npgo22/chickensticks/chickensticks.kicad_pcb

## KiCad design chickensticks.kicad_pcb (2026-04-28)

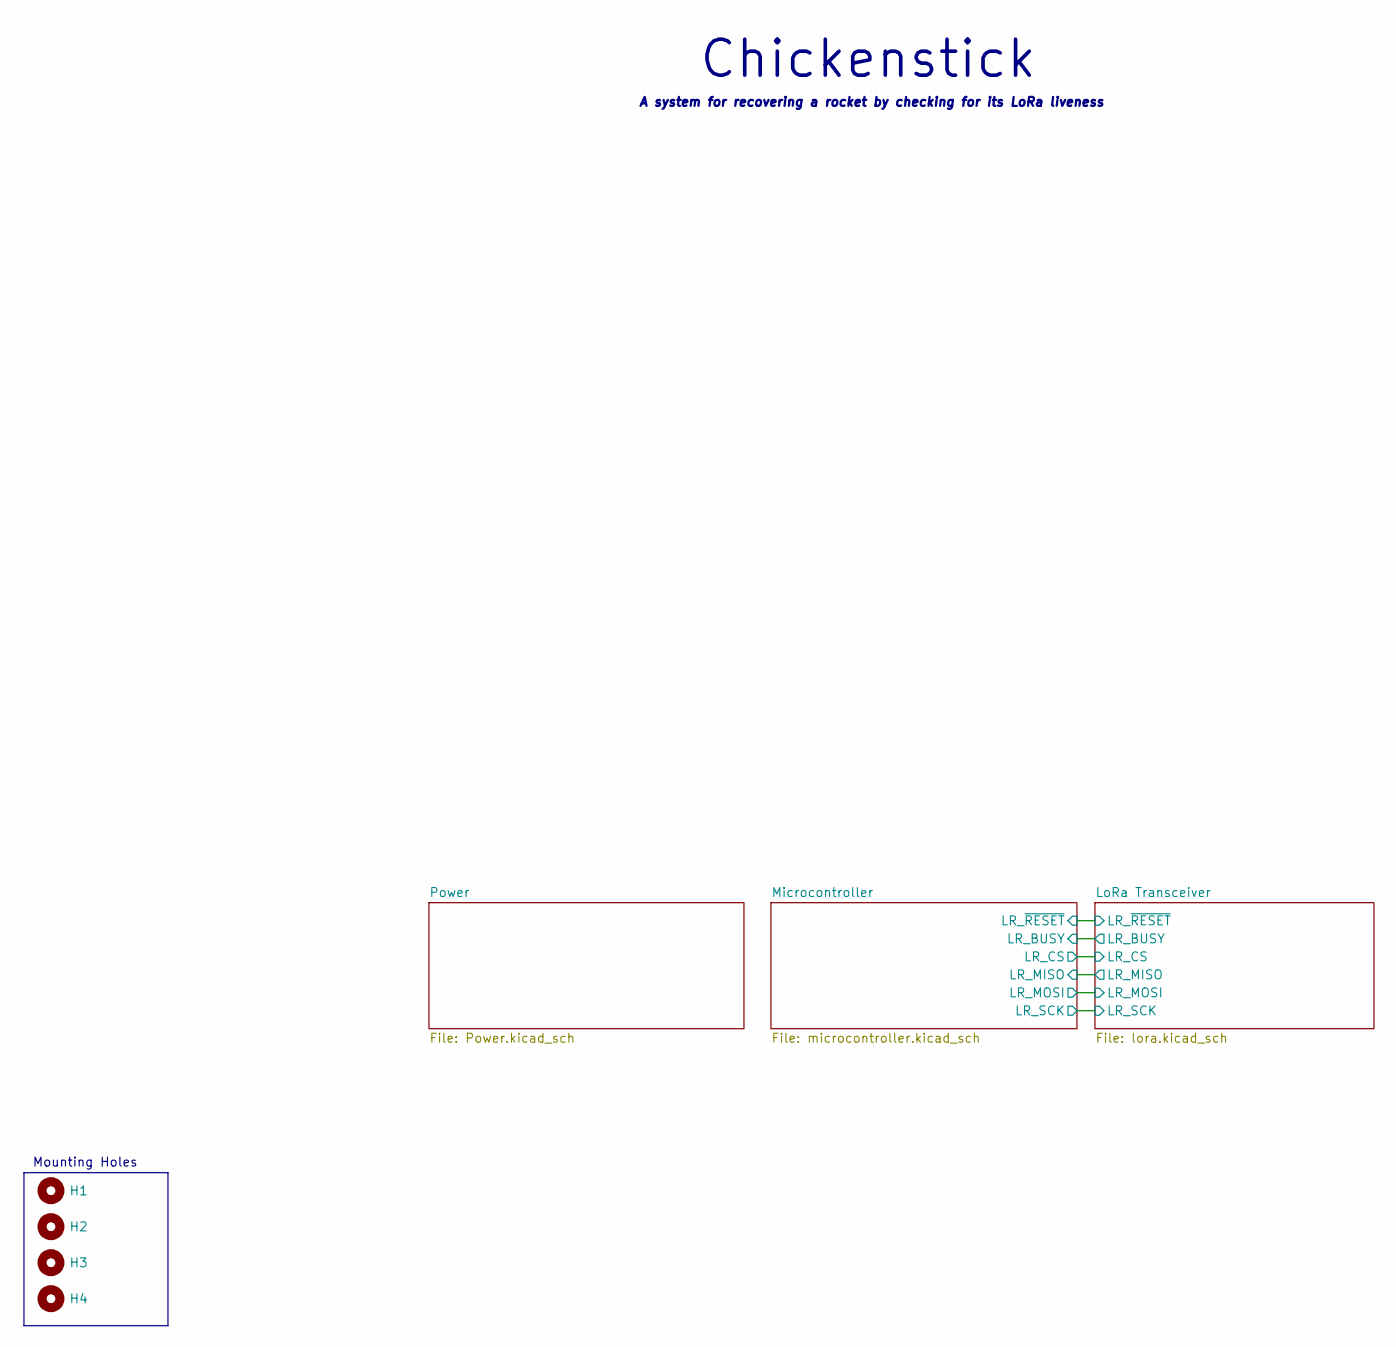
[picture p2: schematic chickensticks.kicad_sch, Chickenstick]

Parts:
H1, H2, H3, H4: MountingHole; MountingHole_3.2mm_M3

Notes on the sheet:
Chickenstick
A system for recovering a rocket by checking for its LoRa liveness
Mounting Holes

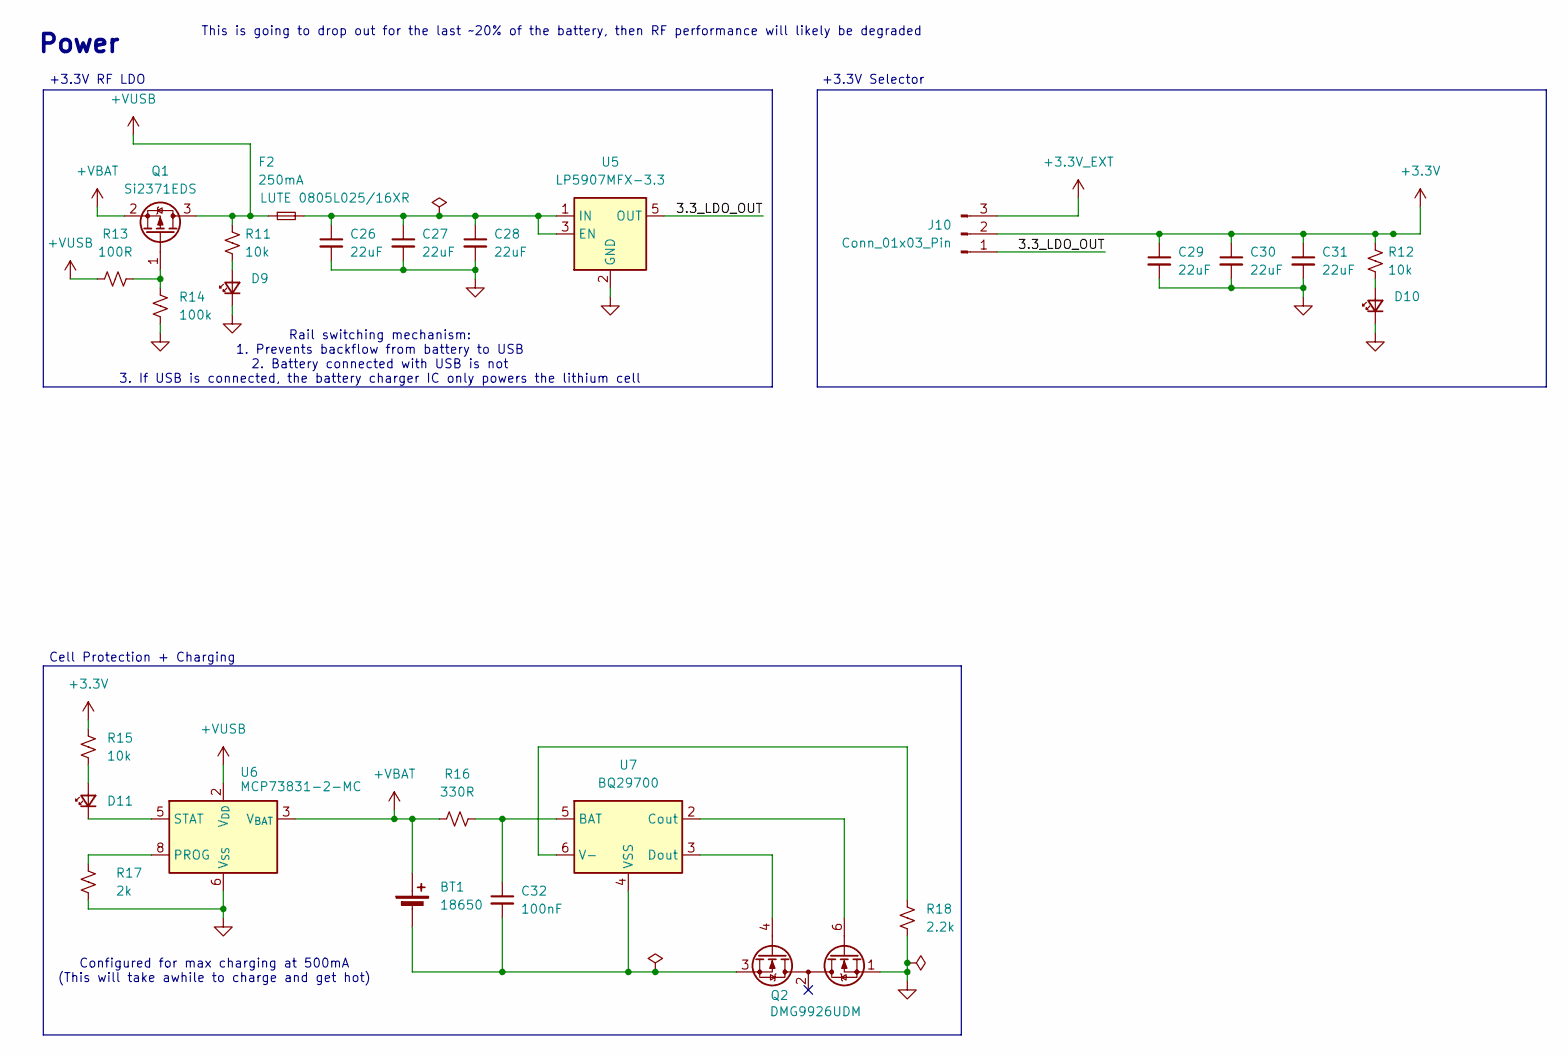
[picture p3: schematic Power.kicad_sch, Chickenstick]

Parts:
BT1: 18650; BatteryHolder_Keystone_1042_1x18650
C26, C27, C28, C29, C30, C31: 22uF; C_0805
C32: 100nF; C_0603
D9, D10, D11: LED_Small; LED_0603
F2: 250mA; Fuse_0805_2012Metric
J10: Conn_01x03_Pin; PinHeader_1x03_P2.54mm_Vertical
Q1: Si2371EDS; SOT-23
Q2: DMG9926UDM; SOT-23-6
R11, R12, R15: 10k; R_0603
R13: 100R; R_0603
R14: 100k; R_0603
R16: 330R; R_0603
R17: 2k; R_0603
R18: 2.2k; R_0603
U5: LP5907MFX-3.3; SOT-23-5
U6: MCP73831-2-MC; DFN-8-1EP_3x2mm_P0.5mm_EP1.7x1.4mm
U7: BQ29700; WSON-6_1.5x1.5mm_P0.5mm

Connections:
+3.3V: C29.1, C30.1, C31.1, J10.2, R12.1, R15.2; also elsewhere on the board
+3.3V_EXT: J10.3; also elsewhere on the board
+VUSB: F2.1, Q1.3 (D), R11.1, R13.1, U6.1 (V_{DD}), U6.2 (V_{DD}); also elsewhere on the board
/Power/3.3_LDO_OUT: J10.1, U5.5 (OUT)
unnamed: BT1.2 (-), C32.2, Q2.3 (S2), U7.4 (VSS)
unnamed: D9.2 (A), R11.2
unnamed: D10.2 (A), R12.2
unnamed: D11.2 (A), R15.1
unnamed: D11.1 (K), U6.5 (STAT)
unnamed: Q1.1 (G), R13.2, R14.1
unnamed: Q2.6 (G1), U7.2 (Cout)
unnamed: Q2.4 (G2), U7.3 (Dout)
unnamed: C26.1, C27.1, C28.1, F2.2, U5.1 (IN), U5.3 (EN)
unnamed: R17.1, U6.8 (PROG)
unnamed: C32.1, R16.2, U7.5 (BAT)
unnamed: R18.1, U7.6 (V-)

Notes on the sheet:
Configured for max charging at 500mA (This will take awhile to charge and get hot)
This is going to drop out for the last ~20% of the battery, then RF performance will likely be degraded
Power
Rail switching mechanism: 1. Prevents backflow from battery to USB 2. Battery connected with USB is not 3. If USB is connected, the battery charger IC only powers the lithium cell
+3.3V RF LDO
Cell Protection + Charging
+3.3V Selector

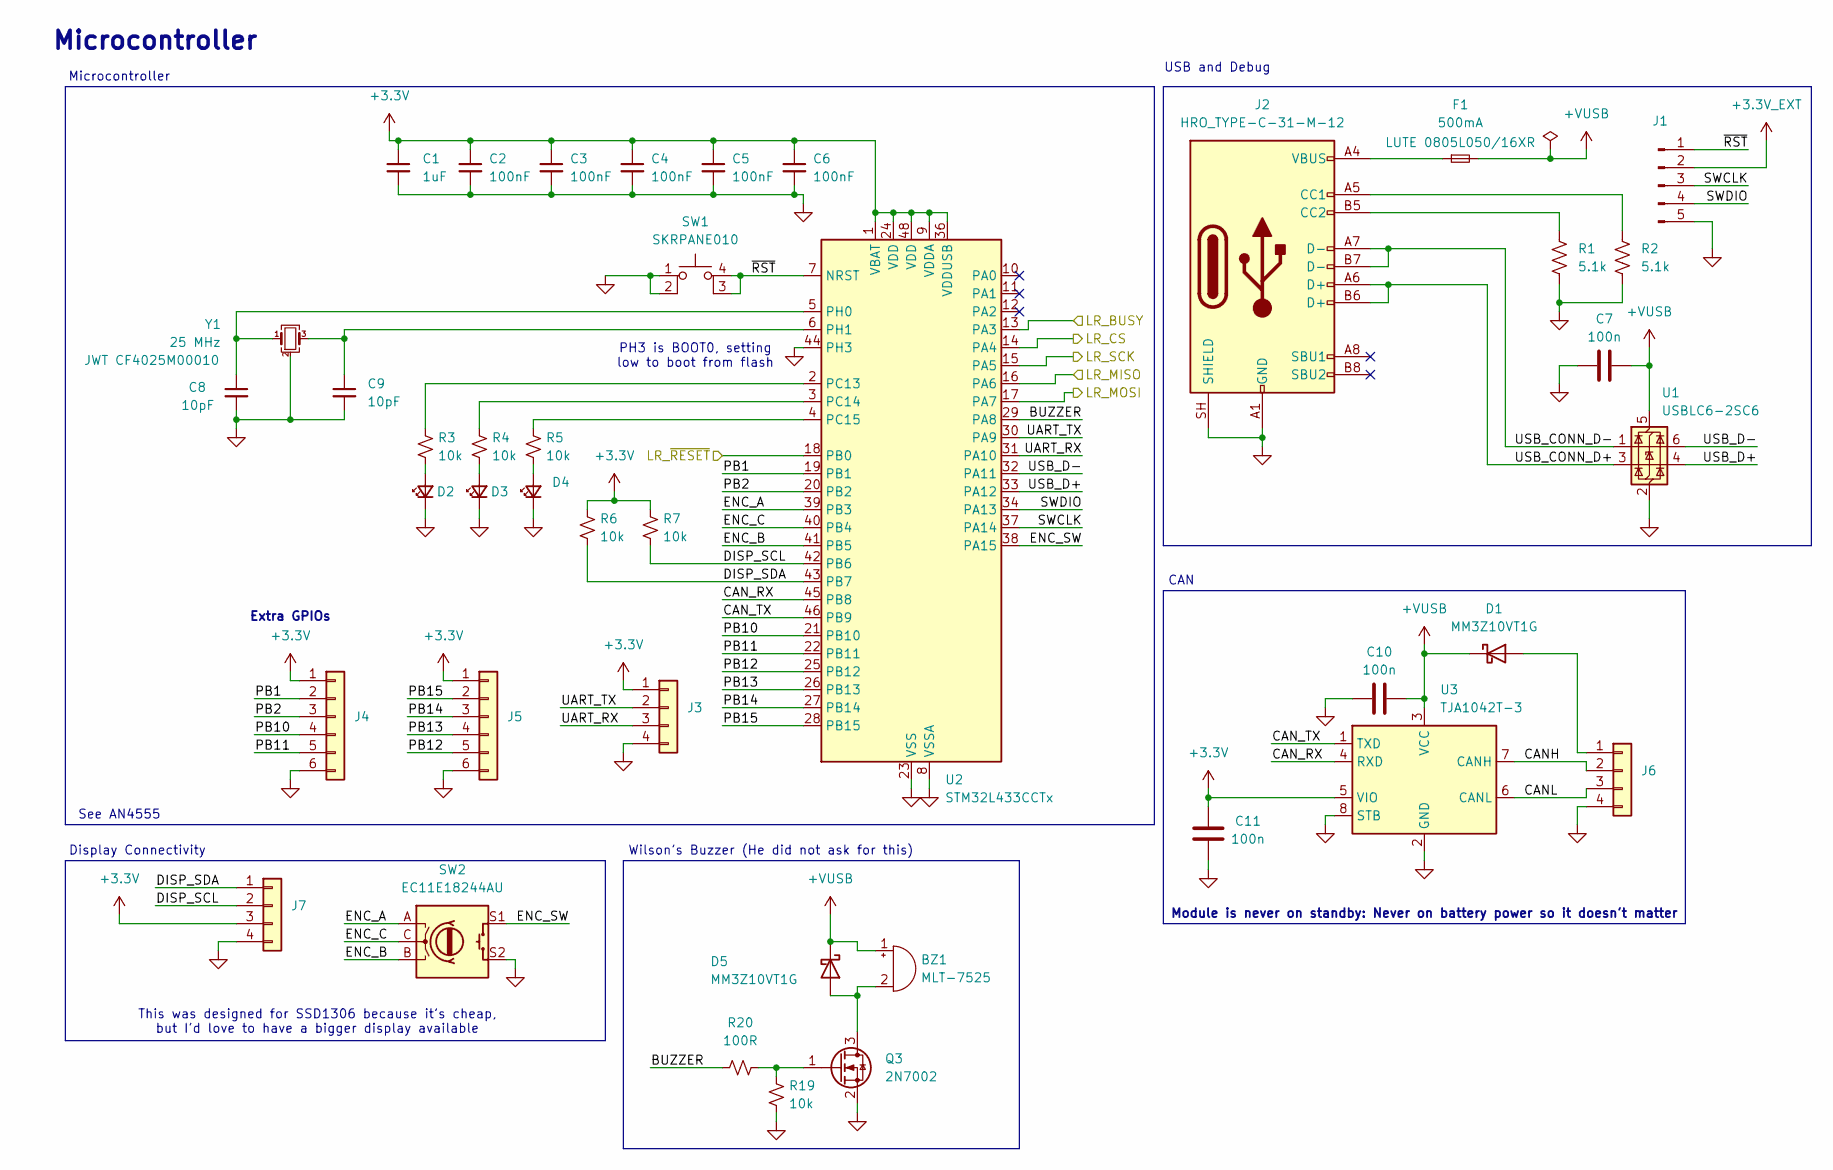
[picture p4: schematic microcontroller.kicad_sch, Chickenstick]

Parts:
BZ1: MLT-7525
C1: 1uF; C_0805
C2, C3, C4, C5, C6: 100nF; C_0603
C7, C10, C11: 100n; C_0603
C8, C9: 10pF; C_0603
D1, D5: MM3Z10VT1G; SOD-323
D2, D3, D4: LED_Small; LED_0603
F1: 500mA; Fuse_0805_2012Metric
J1: Conn_01x05_Pin; PinHeader_1x05_P2.54mm_Vertical
J2: HRO_TYPE-C-31-M-12; USB_C_Receptacle_HRO_TYPE-C-31-M-12
J3, J6, J7: Conn_01x04; PinHeader_1x04_P2.54mm_Vertical
J4, J5: Conn_01x06; PinHeader_1x06_P2.54mm_Vertical
Q3: 2N7002; SOT-23
R1, R2: 5.1k; R_0603
R3, R4, R5, R6, R7, R19: 10k; R_0603
R20: 100R; R_0603
SW1: SKRPANE010
SW2: EC11E18244AU; RotaryEncoder_Alps_EC11E-Switch_Vertical_H20mm_MountingHoles
U1: USBLC6-2SC6; SOT-23-6
U2: STM32L433CCTx; LQFP-48_7x7mm_P0.5mm
U3: TJA1042T-3; SOIC-8_3.9x4.9mm_P1.27mm
Y1: 25 MHz; 3225-4P-L

Connections:
+3.3V: C1.1, C2.1, C3.1, C4.1, C5.1, C6.1, C11.2, J3.1, J4.1, J5.1, J7.3, R6.1, R7.1, U2.1 (VBAT), U2.9 (VDDA), U2.24 (VDD), U2.36 (VDDUSB), U2.48 (VDD), U3.5 (VIO); also elsewhere on the board
+3.3V_EXT: J1.2; also elsewhere on the board
+VUSB: BZ1.1 (+), C7.2, C10.2, D1.1 (K), D5.1 (K), F1.2, U1.5 (VBUS), U3.3 (VCC); also elsewhere on the board
/LoRa Transceiver/LR_BUSY: U2.13 (PA3); also elsewhere on the board
/LoRa Transceiver/LR_CS: U2.14 (PA4); also elsewhere on the board
/LoRa Transceiver/LR_MISO: U2.16 (PA6); also elsewhere on the board
/LoRa Transceiver/LR_MOSI: U2.17 (PA7); also elsewhere on the board
/LoRa Transceiver/LR_SCK: U2.15 (PA5); also elsewhere on the board
/LoRa Transceiver/LR_~RESET: U2.18 (PB0); also elsewhere on the board
/Microcontroller/BUZZER: R20.1, U2.29 (PA8)
/Microcontroller/CANH: J6.2, U3.7 (CANH)
/Microcontroller/CANL: J6.3, U3.6 (CANL)
/Microcontroller/CAN_RX: U2.45 (PB8), U3.4 (RXD)
/Microcontroller/CAN_TX: U2.46 (PB9), U3.1 (TXD)
/Microcontroller/DISP_SCL: J7.2, R7.2, U2.42 (PB6)
/Microcontroller/DISP_SDA: J7.1, R6.2, U2.43 (PB7)
/Microcontroller/ENC_A: SW2.A, U2.39 (PB3)
/Microcontroller/ENC_B: SW2.B, U2.41 (PB5)
/Microcontroller/ENC_C: SW2.C, U2.40 (PB4)
/Microcontroller/ENC_SW: SW2.S1, U2.38 (PA15)
/Microcontroller/PB1: J4.2, U2.19 (PB1)
/Microcontroller/PB2: J4.3, U2.20 (PB2)
/Microcontroller/PB10: J4.4, U2.21 (PB10)
/Microcontroller/PB11: J4.5, U2.22 (PB11)
/Microcontroller/PB12: J5.5, U2.25 (PB12)
/Microcontroller/PB13: J5.4, U2.26 (PB13)
/Microcontroller/PB14: J5.3, U2.27 (PB14)
/Microcontroller/PB15: J5.2, U2.28 (PB15)
/Microcontroller/SWCLK: J1.3, U2.37 (PA14)
/Microcontroller/SWDIO: J1.4, U2.34 (PA13)
/Microcontroller/UART_RX: J3.3, U2.31 (PA10)
/Microcontroller/UART_TX: J3.2, U2.30 (PA9)
/Microcontroller/USB_CONN_D+: J2.A6 (D+), J2.B6 (D+), U1.3 (I/O2)
/Microcontroller/USB_CONN_D-: J2.A7 (D-), J2.B7 (D-), U1.1 (I/O1)
/Microcontroller/USB_D+: U1.4 (I/O2), U2.33 (PA12)
/Microcontroller/USB_D-: U1.6 (I/O1), U2.32 (PA11)
/Microcontroller/~RST: J1.1, SW1.3 (K), SW1.4 (A), U2.7 (NRST)
unnamed: BZ1.2 (-), D5.2 (A), Q3.3 (D)
unnamed: D1.2 (A), J6.1
unnamed: D2.2 (A), R3.2
unnamed: D3.2 (A), R4.2
unnamed: D4.2 (A), R5.2
unnamed: F1.1, J2.A4 (VBUS), J2.A9 (VBUS), J2.B4 (VBUS), J2.B9 (VBUS)
unnamed: J2.A5 (CC1), R2.1
unnamed: J2.B5 (CC2), R1.1
unnamed: Q3.1 (G), R19.1, R20.2
unnamed: R3.1, U2.2 (PC13)
unnamed: R4.1, U2.3 (PC14)
unnamed: R5.1, U2.4 (PC15)
unnamed: C8.1, U2.5 (PH0), Y1.1
unnamed: C9.1, U2.6 (PH1), Y1.3

Notes on the sheet:
Microcontroller
Extra GPIOs
Module is never on standby: Never on battery power so it doesn't matter
See AN4555
Display Connectivity
Wilson's Buzzer (He did not ask for this)
This was designed for SSD1306 because it's cheap, but I'd love to have a bigger display available
CAN
PH3 is BOOT0, setting low to boot from flash
USB and Debug

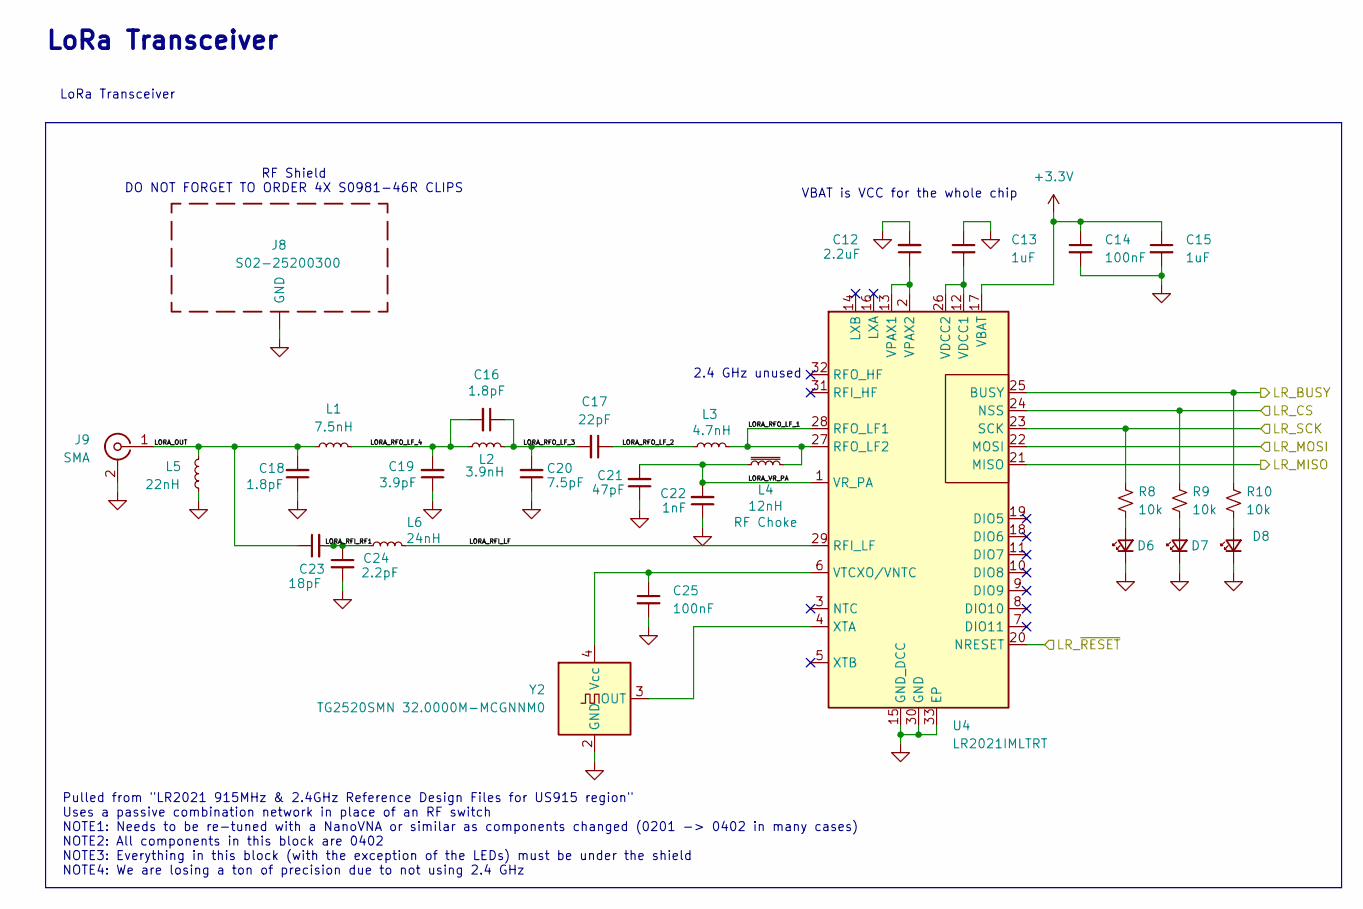
[picture p5: schematic lora.kicad_sch, Chickenstick]

Parts:
C12: 2.2uF; C_0805
C13, C15: 1uF; C_0805
C14, C25: 100nF; C_0603
C16, C18: 1.8pF; C_0402
C17: 22pF; C_0402
C19: 3.9pF; C_0402
C20: 7.5pF; C_0402
C21: 47pF; C_0402
C22: 1nF; C_0402
C23: 18pF; C_0402
C24: 2.2pF; C_0402
D6, D7, D8: LED_Small; LED_0603
J8: S02-25200300; S02-25200300-Outline
J9: SMA; SMA_Amphenol_132203-12_Horizontal
L1: 7.5nH; L_0402
L2: 3.9nH; L_0402
L3: 4.7nH; L_0402
L4: 12nH; L_0402
L5: 22nH; L_0402
L6: 24nH; L_0402
R8, R9, R10: 10k; R_0603
U4: LR2021IMLTRT; QFN-32_EP_5.8x5.8_Pitch0.5mm
Y2: TG2520SMN 32.0000M-MCGNNM0; Oscillator_SMD_SeikoEpson_TG2520SMN-xxx-xxxxxx-4Pin_2.5x2.0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

Connections:
+3.3V: C14.1, C15.1, U4.17 (VBAT); also elsewhere on the board
/LoRa Transceiver/LORA_OUT: C18.2, C23.1, J9.1 (In), L1.1, L5.2
/LoRa Transceiver/LORA_RFI_LF: L6.2, U4.29 (RFI_LF)
/LoRa Transceiver/LORA_RFI_RF1: C23.2, C24.1, L6.1
/LoRa Transceiver/LORA_RFO_LF_1: L3.2, L4.2, U4.27 (RFO_LF2), U4.28 (RFO_LF1)
/LoRa Transceiver/LORA_RFO_LF_2: C17.1, L3.1
/LoRa Transceiver/LORA_RFO_LF_3: C16.1, C17.2, C20.2, L2.2
/LoRa Transceiver/LORA_RFO_LF_4: C16.2, C19.2, L1.2, L2.1
/LoRa Transceiver/LORA_VR_PA: C21.2, C22.2, L4.1, U4.1 (VR_PA)
/LoRa Transceiver/LR_BUSY: R10.1, U4.25 (BUSY); also elsewhere on the board
/LoRa Transceiver/LR_CS: R9.1, U4.24 (NSS); also elsewhere on the board
/LoRa Transceiver/LR_MISO: U4.21 (MISO); also elsewhere on the board
/LoRa Transceiver/LR_MOSI: U4.22 (MOSI); also elsewhere on the board
/LoRa Transceiver/LR_SCK: R8.1, U4.23 (SCK); also elsewhere on the board
/LoRa Transceiver/LR_~RESET: U4.20 (NRESET); also elsewhere on the board
unnamed: D6.2 (A), R8.2
unnamed: D7.2 (A), R9.2
unnamed: D8.2 (A), R10.2
unnamed: C13.2, U4.12 (VDCC1), U4.26 (VDCC2)
unnamed: C12.1, U4.2 (VPAX2), U4.13 (VPAX1)
unnamed: C25.1, U4.6 (VTCXO/VNTC), Y2.4 (Vcc)
unnamed: U4.4 (XTA), Y2.3 (OUT)

Notes on the sheet:
RF Shield DO NOT FORGET TO ORDER 4X S0981-46R CLIPS
2.4 GHz unused
Pulled from "LR2021 915MHz & 2.4GHz Reference Design Files for US915 region" Uses a passive combination network in place of an RF switch NOTE1: Needs to be re-tuned with a NanoVNA or similar as components changed (0201 -> 0402 in many cases) NOTE2: All components in this block are 0402 NOTE3: Every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
VBAT is VCC for the whole chip
LoRa Transceiver

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
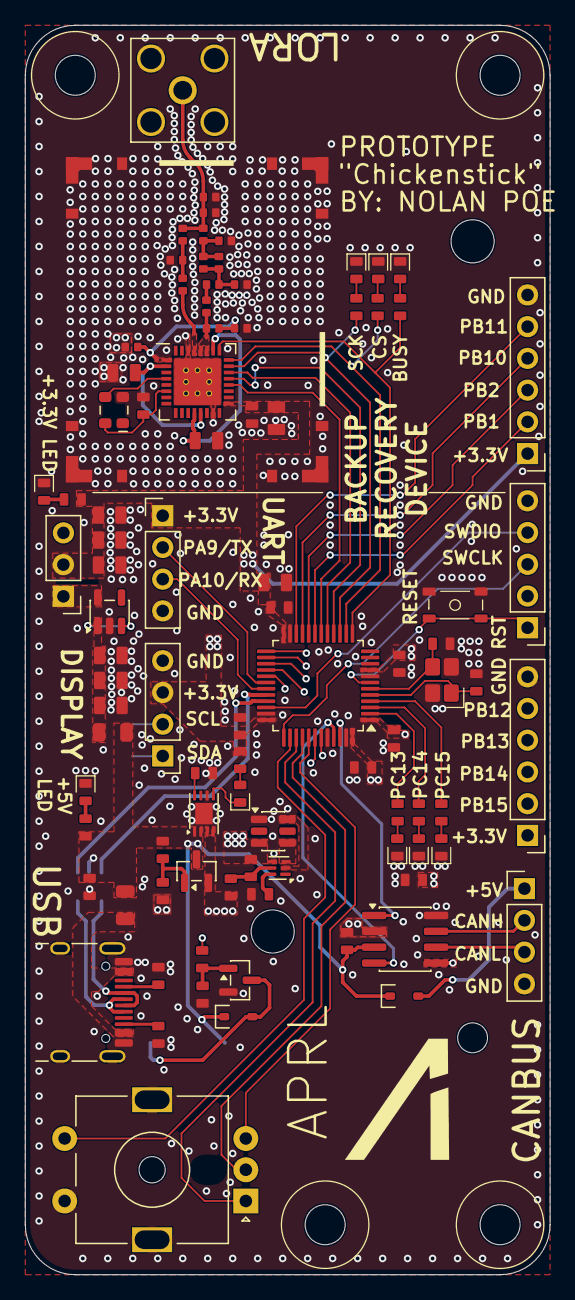
[picture p6: board chickensticks.kicad_pcb from above]

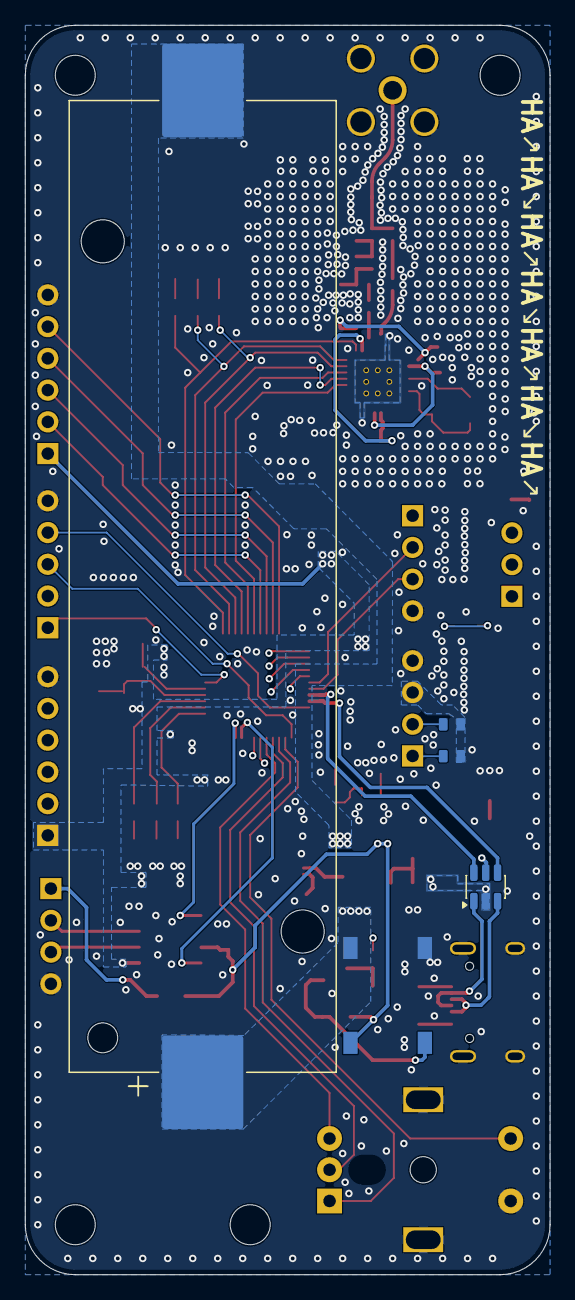
[picture p7: board chickensticks.kicad_pcb from below]

Board: 4 copper layers, 42.0 x 100.0 mm, 101 parts (5 on the bottom side), 81 nets.
