npgo22/chickensticks/chickensticks.ioc

Mcu.UserName=STM32L433CCTx
PA10.Signal=USART1_RX
PA11.Signal=USB_DM
PA12.Signal=USB_DP
PA3.GPIO_Label=LR_BUSY
PA3.Signal=GPIO_Input
PA4.GPIO_Label=LR_CS
PA4.Signal=GPIO_Output
PA5.Signal=SPI1_SCK
PA6.Signal=SPI1_MISO
PA7.Signal=SPI1_MOSI
PA8.Signal=GPIO_Output
PA9.Signal=USART1_TX
PB0.GPIO_Label=LR_RESET
PB0.Signal=GPIO_Output
PB5.Signal=GPIO_Input
PB6.Signal=I2C1_SCL
PB7.Signal=I2C1_SDA
PB8.Signal=CAN1_RX
PB9.Signal=CAN1_TX
PC13.GPIO_Label=LED1
PC13.Signal=GPIO_Output
PH3-BOOT0.GPIO_Label=BOOT0
PH3-BOOT0.Signal=EVENTOUT
