npgo22/chickensticks/(commit log)

2026-04-24 Initial review version
    [Power.kicad_sch, chickensticks.kicad_pcb, chickensticks.kicad_sch, lora.kicad_sch, microcontroller.kicad_sch]
2026-04-24 Implement first stage of review fixes
    [chickensticks.kicad_pcb]
2026-04-24 Add buzzer, fix some erc
    [Power.kicad_sch, chickensticks.kicad_pcb, lora.kicad_sch, microcontroller.kicad_sch]
2026-04-24 Run cleanup tracks and vias
    [chickensticks.kicad_pcb]
2026-04-28 Remove big SS14 diodes
    [chickensticks.kicad_pcb, chickensticks.kicad_sch, microcontroller.kicad_sch]
2026-04-28 Add external 3.3V selector (noise is not real anyway)
    [Power.kicad_sch, chickensticks.kicad_pcb, microcontroller.kicad_sch]
